Ashtonantony28/SpikeMesh/tests/system/cycles_vs_spikes.csv

sample | label | pred | input_events | hidden_spikes | output_spikes | run_cycles | reset_cycles | max_step_cycles | min_step_cycles | sops
0 | 7 | 7 | 794 | 1153 | 25 | 63047 | 0 | 3359 | 1503 | 214794
1 | 2 | 2 | 1176 | 1177 | 34 | 76080 | 1893 | 4062 | 1854 | 312826
2 | 1 | 1 | 498 | 1098 | 32 | 51864 | 1893 | 3167 | 889 | 138468
3 | 0 | 0 | 1256 | 1162 | 37 | 78114 | 1893 | 3902 | 2271 | 333156
4 | 4 | 4 | 827 | 1137 | 31 | 63618 | 1893 | 3647 | 1247 | 223082
5 | 1 | 1 | 625 | 1260 | 34 | 61065 | 1893 | 3455 | 1440 | 172600
6 | 4 | 4 | 946 | 1167 | 33 | 68360 | 1893 | 3711 | 1631 | 253846
7 | 9 | 9 | 783 | 1049 | 47 | 59439 | 1893 | 3455 | 918 | 210938
8 | 5 | 5 | 1163 | 1326 | 40 | 80391 | 1893 | 4447 | 1983 | 310988
9 | 9 | 9 | 1034 | 1191 | 37 | 71937 | 1893 | 3775 | 1503 | 276614
10 | 0 | 0 | 1355 | 1269 | 33 | 84701 | 1893 | 4383 | 2111 | 359570
11 | 6 | 6 | 1211 | 1116 | 30 | 75210 | 1893 | 4095 | 1599 | 321176
12 | 9 | 9 | 900 | 1146 | 38 | 66216 | 1893 | 3487 | 1599 | 241860
13 | 0 | 0 | 1185 | 1197 | 41 | 76961 | 1893 | 3999 | 1855 | 315330
14 | 1 | 1 | 778 | 1182 | 28 | 63469 | 1893 | 3455 | 702 | 210988
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
