Ashtonantony28/SpikeMesh/tests/system/cycles_vs_spikes.png

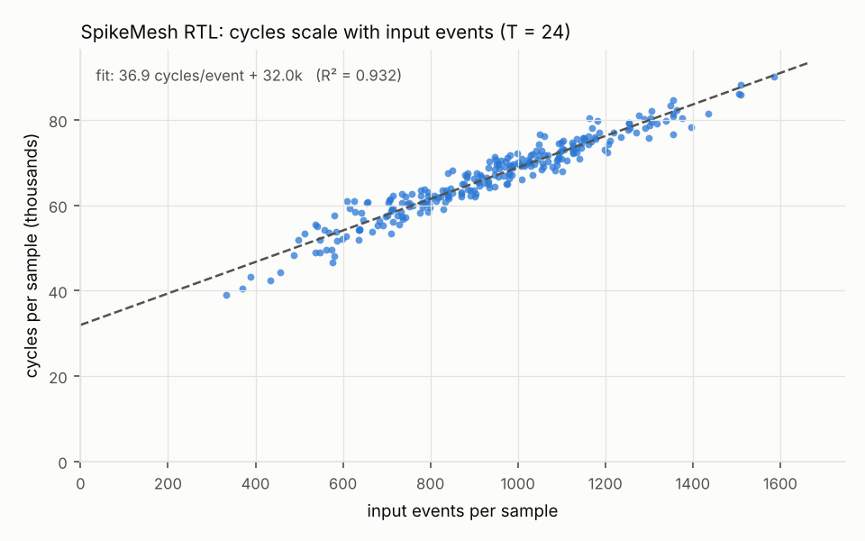
tests/system/cycles_vs_spikes.png
