Ashtonantony28/SpikeMesh/(commit log)

2026-11-06 SG4: compiler, config image, host API; SPEC clarifications on reset and host dest_y
    Claude-Session: https://claude.ai/code/session_01VH3AycfZqWcgo9o8h4pGEf
    [api.py]
2026-11-06 SG2: inference neurocore RTL, cocotb + Verilator tests vs golden (28 pass); SPEC: acc width and UPDATE flow rules
    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
2026-11-07 SG7: KV260 wrapper, UART/AXIS host bridges, Vivado scripts (unrun), FPGA host backends (6 tests)
    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
2026-11-07 SG5: full-chip RTL bit-exact vs golden (random nets, trained net 256 samples, STDP readback); performance numbers
    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
    [cycles_vs_spikes.csv]
2026-11-07 AUDIT-1: fix trace memory reset (H1) and DMA readback deadlock (H2); audit report
    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
    [core_model.py, fpga_backend.py, learn_engine.sv, test_core.py, test_fpga.py]
